cfle831/209-Group-31/README.md

# 209-Group-31
Repo for Group 31 to do our good work

# TO DO
- [x] Zero crossing comparater working.
- [x] Arrange the design in a readable and sensible manner
- [ ] Make a full wave rectifier (Not doing this, kept for the record)
- [x] Change values to e12 values
- [ ] Make a second order filter for the sensors (Not doing this, kept for the record)
- [ ] Test the simulation for noise reduction
- [ ] Test the circuit in real life
- [ ] UART finished
- [x] Altium schematic made
- [x] Altium PCB made
