cfle831/209-Group-31/voltage_sine_wave.png

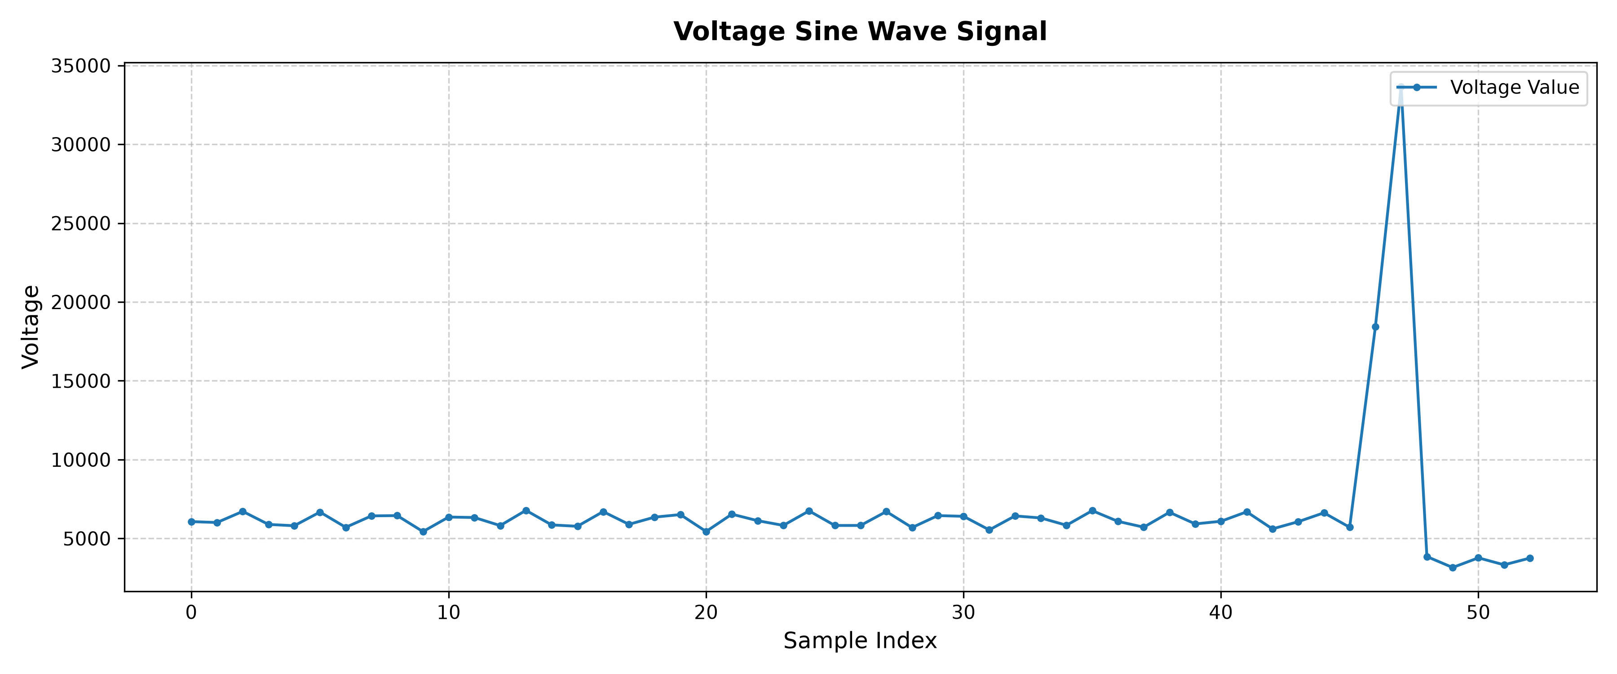
voltage_sine_wave.png
