cfle831/209-Group-31/PCB/EE209 component values.txt

EE209 Resistor values used
Resistor (Intended Value) Value used
R1 (47k) - 46.3k
R2 (82k) - 82.09k
R3 (3.9k) - 3.878k
R7 (33k) - 33.3k
R8 (56k) - 54.82k
R9 (100k) - 99.7k
Rs (3x1.5 --> 0.5) - 0.502
 - 1.51
 - 1.51
 - 1.499
R10 (22k) - 22.38k
R11 (100k) - 100.0k
R12 (15k) - 15.11k
R14 (22k) - 21.93k
R16 (56k) - 55.44k
R19 (22) - 22.16

EE209 Capacitor values used
C11 (100nF) - 101.4nF
C1 (10uF) - 8.9uF
C8 (15nF) - 14.9nF
C13 (100nF) - 100.7nF

EE209 Diodes used
D1 (2.7V) - 2.172V, threshold 0.72V
D2 (2.7V) - 2.226V, threshold 0.72V
D3 (2.7V) - 2.147V, threshold 0.715V
D4 (2.7V) - 2.210V, threshold 0.711V

Debug:
2026/10/9 7pm:
Potentially wrong resistor values:
current R1 onboard reads(color bands):
1st digit / 2nd digit / 3rd digit / multiplier / tolerance
Green / Purple / Black / Red / Brown
5 / 7 / 0 / 100 / 1%
so that translates to 57k ohms
current R7 onboard reads(color bands):
1st digit / 2nd digit / 3rd digit / multiplier / tolerance
Orange / Orange / Black / Brown / Brown
3 / 3 / 0 / 10 / 1%
so that translates to 3.3k ohms
and then if we do 5 * 3.3/(50 + 3.3) = 0.273V, which is ~300mV that we got by measuring the thing irl
which explain why thefu ohe offset is 0.3v

2026/10/12 12.00:
Turns out R13 had the wrong value. Downgrading it from 100k ohm to 15k ohm enabled zero crossing to work.
The Schmmit trigger has a certain gain, given the previous resistance of R13 was 100k, despite the ratio was
meant to be ~1:39(ratio between R13 and R18). We actually calculated this before but was hallucinating on the day
when we made the schematici on Altium Designer.

Brave attempt:
3rd new resistor at the bottom layer at R19
R19_3(56) - 56.12

New R13(15k) - 15.08k
