cfle831/209-Group-31/LtSpice_Hardware_Simulations/PowerSensSim.asc

C1: cap; 10µ
C6: cap; 15nF
C8: cap; 15nF
C9: cap; 470µ; Rser=0.001
C10: cap; 100µ; Rser=0.001
D1: diode; 1N4148
Lload: ind; 4mH
Noise: voltage; SINE(0 0.001 10k)
R1: res; 47k
R2: res; 82k
R3: res; 3.9k
R4: res; 1.5
R5: res; 1.5
R6: res; 1.5
R7: res; 33k
R8: res; 56k
R9: res; 100k
R10: res; 22k
R11: res; 100k
R12: res; 15k
R13: res; 15k
R14: res; 22k
R15: res; 100k
R16: res; 56k
R17: res; 100k
R18: res; 560k
Reg: LT1085-5
Rin1: res; 56
Rin2: res; 56
Rin: res; 56
RL: res; 75
Rload: res; 52.5
U1: opamp2; LM324
U2: opamp2; LM324
U5: opamp2; LM324
U21: opamp2; LM324
Vsupply: voltage; SINE(0 19.8 500)
Named nets: 0, Vac, 5V, 2V1, Vfi, Vin, Vfv, 2v1, Vio, Vvo, Vii, Vvi, Vzc, Vvd
.ac dec 30 1 1Meg
.lib LM324.lib
AC Source, Load and Sensors
Source Sensing circuit
Load 
(2.5VA-7.5VA)
Voltage Sens
(Vvs(max)=?)
Simulation Commands
- Change these as needed
Current sense Opamp
Voltage Sense Opamp
.tran 0 0.2 0 0.01m
.ic V(Vin)=8
Voltage Regulator Circuit
Low Pass Filter Circuit
Maximum Current Setup:
 - Vsupply = 21.778 V
 - Rload = 29 Ohm
Minimum Current Setup:
 - Vsupply = 18.82 V
 - Rload = 62.25
Zero crossing Comparator
As we only need one zero crossing detector,
we will use the voltage sensor for this.
Previously it was the current sensor but that could 
vary too much
2v1 supply
Gain For Voltage sense: ~1/22   (0.04540)
For (Ra, Rb) = (82k, 3.9k)
This Rl is used to *roughly*
 visualise the effect 
of the entire circuit
on the regulator
Vnoise is used to approximately 
show some of the effect of 
noise on simulation
Vfv and Vfi go to the 
adc pins of the atmega328p
