cfle831/209-Group-31/LtSpice_Hardware_Simulations/Lab3_SignCond.asc

C1: cap; 10µ
Cf: cap; 1nF
Cin: cap; 47µ; Rser=0.001
Cout: cap; 10µ; Rser=0.001
D1: diode; 1N4148
Lload: ind; 4mH
R1: res; 47k
R1a3: res; 200k
R1a4: res; 500k
R1b3: res; 200k
R1b4: res; 500k
R2: res; 33k
R2a3: res; 500k
R2a4: res; 500k
R2b3: res; 500k
R2b4: res; 500k
R3: res; 50k
R4: res; 10k
Ra: res; 21k
Rb: res; 1k
Reg: LT1085-5
Rf: res; 15k
Rin: res; 10
RL: res; 50
Rload: res; 94
Rs: res; 0.5
U1: opamp2; LM324
U3: opamp2; LM324
U21: opamp2; LM324
V1: voltage; SINE(1 1 500)
V2: voltage; 1
V3: voltage; SINE(0 0.1 500); AC .1 0
V4: voltage; SINE(2.1 1 500); AC 1 0
Vsupply: voltage; SINE(0 21.78 500)
Named nets: 0, Vac, Vsens, Vis, Vvs, 5V, Vio, 2V1, Vvo, Vopamp, Vfilter, Vin, Vzc, Vsch
.ac dec 30 1 1Meg
.lib LM324.lib
Power/Signal Sources
AC Source, Load and Sensors
Notes: 
- These sources are used by more than 1 model and therefore
   be mindful that changing these will effect most parts
Source Sensing circuit
Load 
(2.5VA-7.5VA)
Current Sens 
(Pmax=?)
Voltage Sens
(Vvs(max)=?)
Simulation Commands
- Change these as needed
Current sense Opamp
Voltage Sense Opamp
Low Pass Filter Circuit
.tran 0 0.2 0 0.01m
.ic V(Vin)=8
Voltage Regulator Circuit
Prototype for Zero crossing Comparator
