cfle831/209-Group-31/(list of files, drawings)

Other design files:
Proteus/Lab6_Proteus/Lab6_PI_Proteus.pdsprj
Proteus/Lab6_Proteus/Lab6_PII_Proteus.pdsprj
Proteus/Lab6_Proteus/Project Backups/Lab6_PI_Proteus [20260928, 12-34-22].pdsprj
Proteus/Lab6_Proteus/Project Backups/Lab6_PII_Proteus [20261014, 20-17-52].pdsprj
Proteus/Lab6_Proteus/Project Backups/Lab6_PII_Proteus [20261015, 15-12-39].pdsprj
Proteus/Overall_Project_Proteus.pdsprj
Proteus/Project Backups/Overall_Project_Proteus [20261018, 01-50-07].pdsprj
Proteus/Project Backups/Overall_Project_Proteus [20261018, 12-08-10].pdsprj
Proteus/Project Backups/Overall_Project_Proteus [20261018, 12-18-49].pdsprj
Proteus/Project Backups/Overall_Project_Proteus [20261018, 12-18-50].pdsprj
Proteus/Project Backups/Overall_Project_Proteus [20261018, 12-27-01].pdsprj
Proteus/Project Backups/Overall_Project_Proteus [20261018, 13-01-37].pdsprj
Proteus/Project Backups/Overall_Project_Proteus [20261018, 18-42-38].pdsprj
