cfle831/209-Group-31/PCB/Voltage Testing.txt

For Vvsense:
Vac : 13.36 Vrms
Vvs : 0.6007 Vrms
A=~0.04
In expected range

For Visense
Vac : 12.6 Vrms
Vis : 60 mVrms
In expected range
