cfle831/209-Group-31/testing-script/voltage_sine_wave.csv

Sample_Index | Voltage
0 | 504
1 | 579
2 | 501
3 | 350
4 | 282
5 | 366
6 | 516
7 | 455
8 | 314
9 | 292
10 | 412
11 | 550
12 | 565
13 | 441
14 | 306
15 | 299
16 | 427
17 | 559
18 | 392
19 | 285
20 | 327
21 | 475
22 | 576
23 | 527
24 | 378
25 | 283
26 | 339
27 | 488
28 | 579
29 | 372
30 | 282
31 | 344
32 | 494
33 | 579
34 | 511
35 | 359
36 | 281
37 | 356
38 | 507
39 | 474
40 | 327
41 | 286
42 | 393
43 | 538
44 | 572
45 | 460
46 | 317
47 | 290
48 | 407
49 | 548
50 | 449
51 | 310
52 | 295
53 | 419
54 | 554
55 | 562
56 | 434
57 | 302
58 | 302
59 | 433
60 | 562
61 | 386
62 | 284
63 | 333
64 | 481
65 | 578
66 | 522
67 | 372
68 | 282
69 | 344
70 | 495
71 | 480
72 | 331
73 | 285
74 | 387
75 | 534
76 | 574
77 | 466
78 | 321
79 | 289
80 | 401
81 | 544
82 | 459
83 | 316
84 | 291
85 | 409
86 | 548
87 | 566
88 | 444
89 | 307
90 | 297
91 | 423
92 | 557
93 | 395
94 | 287
95 | 325
96 | 472
97 | 576
98 | 530
99 | 381
100 | 284
101 | 336
102 | 485
103 | 578
104 | 375
105 | 283
106 | 341
107 | 492
108 | 579
109 | 513
110 | 362
111 | 281
112 | 353
113 | 504
114 | 469
115 | 324
116 | 288
117 | 398
118 | 542
119 | 570
120 | 455
121 | 314
122 | 292
123 | 412
124 | 550
125 | 457
126 | 315
127 | 291
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
