cfle831/209-Group-31/testing-script/voltage_sine_wave.png

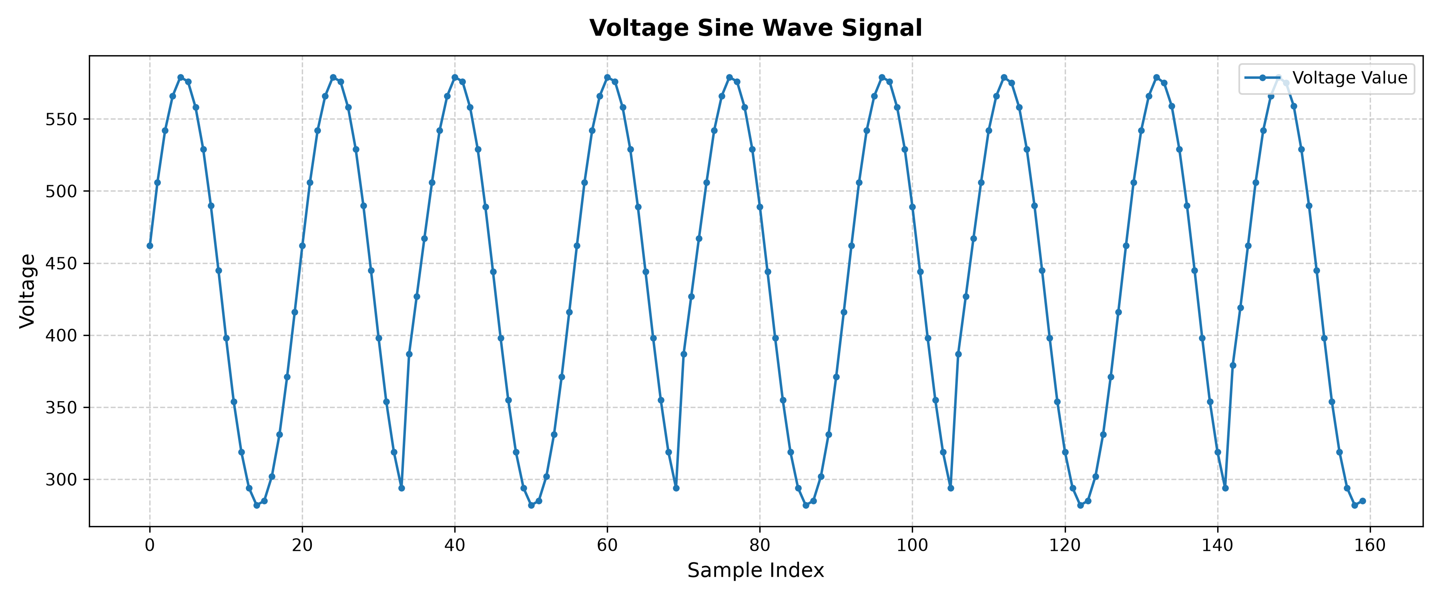
testing-script/voltage_sine_wave.png
