cfle831/209-Group-31/Software/Software Implement/Software Implement/adc.c

/*
 * adc.c
 *
 * Created: 12/09/2026 1:44:14 pm
 * Author : TFE, Ferre
 */ 
#define F_CPU 2000000UL
#define V_REF 5
#include "adc.h"

#include <avr/io.h>
#include <util/delay.h>
#include <stdint.h> //
#include <math.h> //
#include "UART.h"

extern volatile uint8_t adc_samples_full; // From main.c
extern volatile uint8_t start_sampling;
static volatile uint8_t voltage_read = 1;
volatile int16_t voltage[SAMPLES_TO_TAKE];
volatile int16_t current[SAMPLES_TO_TAKE];
static volatile uint8_t idx = 0;

/////// ISR ///////
ISR(ADC_vect) { // ADC conversion complete interrupt
	if (!start_sampling || adc_samples_full) return;
	// sample adc
	// sample voltage then current adc
	
	// Store values from most recent conversion
	uint16_t adc_val = ADC;
	
	if (voltage_read){
		// Log the voltage adc sample in array
		voltage[idx] = adc_val;
		} else {
		// Store current adc sample in array
		current[idx] = adc_val;
	}
	// increment array index
	idx++;
	if (idx == SAMPLES_TO_TAKE){

		// If the full array was current, change flag
		if (!voltage_read){
			// Switch to voltage next time
			voltage_read = 1;
			ADMUX &= (0xF0); // Lower MUX bits
			ADMUX |= VOLTAGE_ADC;
			// Start power calculations
			adc_samples_full = 1;
			} else {
			// Enable interrupt for current sampling
			voltage_read = 0;
			ADMUX &= (0xF0); // Lower MUX bits
			ADMUX |= CURRENT_ADC;
			EIMSK |= (1 << INT0);
		}
		// Reset the index
		idx = 0;
		// stop sampling until next INT0 interrupt
		start_sampling = 0;
	}
}

ISR(INT0_vect){
	idx = 0;
	start_sampling = 1;
	EIMSK &= ~(1 << INT0); // Disable (this) INT0 interrupt
}

void zero_crossing_init(void){
	EICRA |= (3 << ISC00); // INT0 interrupt on rising edge
	EIMSK |= (1 << INT0); // enable INT0 interrupts
}

/* in order to acheive a *maximum* sampling frequency of 10kHz, samples must be taken ~100us apart */
/* Sampling frequency must not be a multiple of 500Hz*/
void adc_init(void){
	// Enable ADC converter
	ADCSRA = (1<<ADEN);
	ADMUX = (1 << REFS0);
	// Clock prescaler of 4
	ADCSRA |= (1 << ADPS1);
	DDRC &= ~(7<<PINC0); // For ADC pins 0, 1, 2 as input
	DDRD &= ~(1<<PIND2); // Zero Crossing Detection pin as input
	
	ADMUX &= (0xF0); // Lower MUX bits
	ADMUX |= VOLTAGE_ADC;
	
	ADCSRA |= (1 << ADSC); // dummy conversion to settle values
	while(!(ADCSRA  & (1<<ADIF))); // Wait for dummy convert to finish
	// Enable adc interrupts
	ADCSRA |= (1 << ADIE); // Enable ADC interrupt
}

// 
int16_t find_load_voltage(uint16_t adc_measurement){
	int32_t return_value;
	return_value = (int32_t)adc_measurement;
	return_value -= V_OFFSET;
	
	return_value /= FILTER_GAIN; 
	return_value /= VIN_DIVIDER;
	return_value *= 1000 * V_REF;
	return_value /= ADC_RESOLUTION;
	return_value *= V_CORRECTIVE;
	return return_value;
}

// 
int16_t find_load_current(uint16_t adc_measurement){
	int32_t return_value;
	return_value = (int32_t)adc_measurement;
	return_value -= I_OFFSET;
	
	return_value *= 1000*V_REF; // to get pure ac value in mV
	return_value /= ADC_RESOLUTION;
	return_value /= (I_OPAMP * FILTER_GAIN * R_SHUNT/I_CORRECTIVE);
	return (return_value);
}

int32_t calculate_instantaneous_power_sample(int16_t v_mV, int16_t i_mA) {
	// (mV * mA) / 1000 = mW
	return ((int32_t)v_mV * (int32_t)i_mA) / 1000L;
}

// Array version: Use this only if you need to log or transmit full power waveforms
void calculate_instantaneous_power_array(const int16_t voltage[], const int16_t current[], uint8_t samples, int32_t inst_power[]) {
	for (uint8_t i = 0; i < samples; i++) {
		inst_power[i] = calculate_instantaneous_power_sample(voltage[i], current[i]);
	}
}

// Real power calculation: Accumulates instantaneous power across all samples in one pass
int32_t calculate_real_power(const int16_t voltage[], const int16_t current[], uint8_t samples) {
	if (samples == 0) return 0;

	int64_t accumulated_power = 0;
	
	for (uint8_t i = 0; i < samples; i++) {
		accumulated_power += calculate_instantaneous_power_sample(voltage[i], current[i]);
	}

	return (int32_t)(accumulated_power / samples);
}



// Calculate rms used for testing 
double calculate_rms(const int16_t *samples, uint8_t count) {
	double sum_of_squares = 0.0;

	for (uint8_t i = 0; i < count; i++) {
		double val = (double)samples[i];
		sum_of_squares += val * val;
	}

	return sqrt(sum_of_squares / count);
}
