cfle831/209-Group-31/(commit log)

2026-08-23 Added LTspice circuit simulation files from lab 3
2026-08-23 begun to convert UART code for correct implementation
2026-08-24 Complete Simple Uart functionality
2026-08-25 Add comparator circuit
2026-08-25 Renamed the LTSpice simulation name from lab3 to PowerSensSim. Made changes that were made in the lab demo.
2026-08-26 style: made the schematic more readable
2026-08-26 fix: added an opamp to deliver 2v1 and changed the resistor values back to the calculated vals.
2026-08-26 perf: improved the zero voltage crossing detector, addded to todo list
2026-09-08 Update Zero Crossing
    Change values of the resistors in the zero crossing OPAMP's to have smaller hysterisis and have shorter delay between true zc and output
2026-09-09 style: I made the ltspice more readable. I also removed the zero crossing detector for the current sensor.
2026-09-09 changed resistor values to be e12 for the current sensing opamp
2026-09-11 add custom component for the pcb
2026-09-11 change Rshunt to 3 parallel resistors
2026-09-17 uploaded PCB related files
2026-09-30 add resistor tracking txt
2026-10-01 add resistor tracking txt but i thought i di that already
2026-10-01 tested regulator values
2026-10-03 feat: made pwm functions, one to init and one to set duty cycle
2026-10-06 add txt file for tracking soldering work, adjust voltage sense divider values
2026-10-08 update for some soldering & testing as well as initial peak current calculation code
2026-10-09 test the Viisense voltage dividor
2026-10-09 measured all zener diodes and some caps, and they are soldered on
2026-10-09 measured and soldered R10, R14, R8, R16, R12
2026-10-12 Inital adc integration into main, lots of testing
2026-10-12 more testing of adc
2026-10-13 update adc stuff
2026-10-14 prevent pins being set as output for testing, fill in methods for using interrupts rather than delay
2026-10-15 Remove uses of floats in adc functions, layout for function that finds the input values from adc meas
2026-10-15 record gain values in relevant adc functions for future use. add full proteus file
2026-10-15 update proteus model to include gain over 1st order filter
2026-10-16 feat: Implemented my PWM code in main
2026-10-16 update adc files
2026-10-16 Feat: changed adc's to be handled in an interrupt
2026-10-16 refac: returned pwm to tc1 as tc0 is suffecient for adc interrupts. Also fixed some small issues in code.
2026-10-16 add function for calculating real power
2026-10-16 refac: made adc a little better
2026-10-16 Change uart decimal_to_char function to handle negative values
2026-10-17 fix issue with Timer0 ISR
2026-10-17 update power function and implement
2026-10-17 improve ltspice sim to be more accurate to pcb
2026-10-17 tried to change adc, failed. it weirds
2026-10-17 fix some issues in adc code, and add comments
2026-10-17 fix: code compiles, voltage reading doesn't work.
2026-10-17 proteus was being stupid all along, adc is fine
2026-10-17 make output to uart look better
2026-10-18 increase samples taken, improve display functions to handle larger values. further correct find_input_voltage to be closer to actual
2026-10-18 further improve the correction values for load_current. add find instantaneous power function. Currently (theory) running out RAM during runtime
2026-10-18 fix: made adc sample voltage first then current
2026-10-18 improve memory usage, remove unnecessary correctional values. currently stops after ~2 minutes of being active
2026-10-18 testing to find why code stops: current theory timer2_compA ISR infinite loop
2026-10-18 fix: Changed the channel switching logic to be in ADC interrupt and ADC interrupt is now always on
2026-10-19 prevent auto triggering just in case
2026-10-19 fix voltage and current arrays being unsigned
2026-10-19 changes for testing real power
2026-10-19 add code for averaging the rms voltage and current
2026-10-19 confirmed sampling issue due to update_led in timer0compA interrupt
2026-10-19 Enable ISR_NOBLOCK for t/c 2 Interrupt, fixing sampling issues. Minor calibration of voltage and current
2026-10-19 Improve commenting and remove some redundant methods. Add uart transmit for real power
2026-10-19 style: made adc.c and adc.h more readable. also removed unused functions
2026-10-20 reduced power fluctuation to 5%
2026-10-20 confirm functionality of uart outputs
